ZhantaoLi/STM32_CAR/README.md

# STM32_CAR
 STM32小车资料整理

B站视频教程链接：

[STM32智能小车V1.5](https://www.bilibili.com/video/av253997024/)

[STM32智能小车V3.3](https://www.bilibili.com/video/av990827294)
