ZhantaoLi/STM32_CAR/平衡车网上例程/balance_car_4/README.md

# balance car

#### 介绍
这是一个通过STM32F103C8T6的hal库基于PID控制算法的平衡小车系统的硬件和软件设计

This is the hardware and software design of a balance car system based on PID control algorithm through STM32F103C8T6.
