ZhantaoLi/STM32_CAR/平衡车网上例程/平衡小车2/readme.txt

https://oshwhub.com/999jump999/stm32-ping-heng-xiao-ju
