ZhantaoLi/STM32_CAR/MPU6050卡尔曼滤波/程序源码/STM32F103C8T6驱动MPU6050程序(卡尔曼滤波_硬件IIC_OLED显示_串口上传)/README.TXT

实验器材:
	STM32F103C8T6系统板+MPU6050模块+0.96寸OLED显示屏+USB转TTL电平工具
	
实验目的:
	MPU6050陀螺仪数据解算（卡尔曼滤波）
	
硬件资源:
	MPU6050： SCL接PB10 SDA接PB11
	OLED： SCL接PA6 SDA接PA7
	指示灯：LED0--PC13
	串口1：RX--PA9  TX--PA10
实验现象:
	通过串口将陀螺仪数据上报，OLED实时显示数据。
注意事项:
	注意接线，硬件平台选择和适配。

该工程借鉴了很多平台的程序设计，本人能力有限，设计难免有问题和漏洞，欢迎大家和我交流。
	
			西安电子科技大学 
			刘亮设计
			QQ:1920108735
			2021年5月17日
