ZhantaoLi/STM32_CAR/MPU6050卡尔曼滤波/原理图/接线图.png

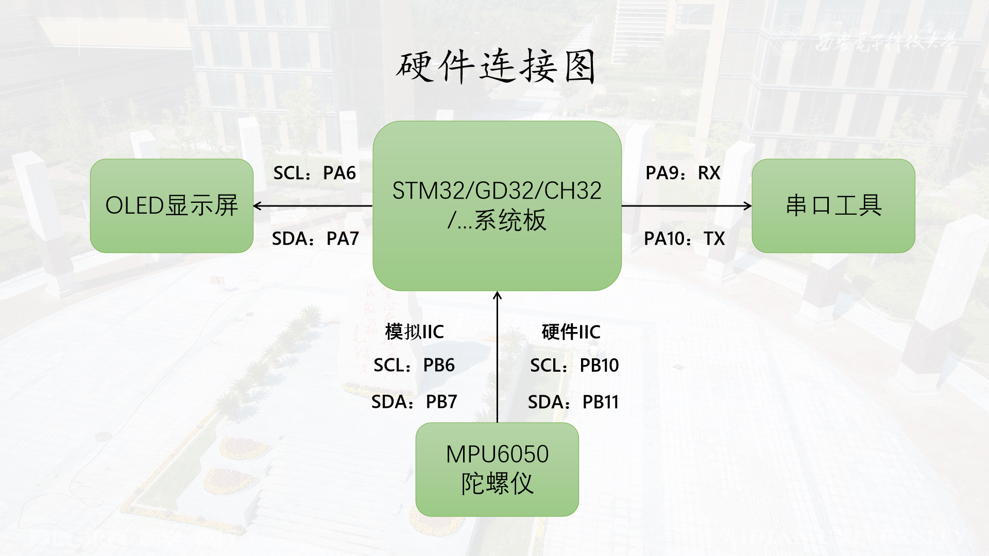
MPU6050卡尔曼滤波/原理图/接线图.png
