ZhantaoLi/STM32_CAR/STM32小车资料V1.5/04小车PCB硬件资料(你要的PCB电路板资料)/小车PCB资料PCB资料_V1.4/PCB图.png

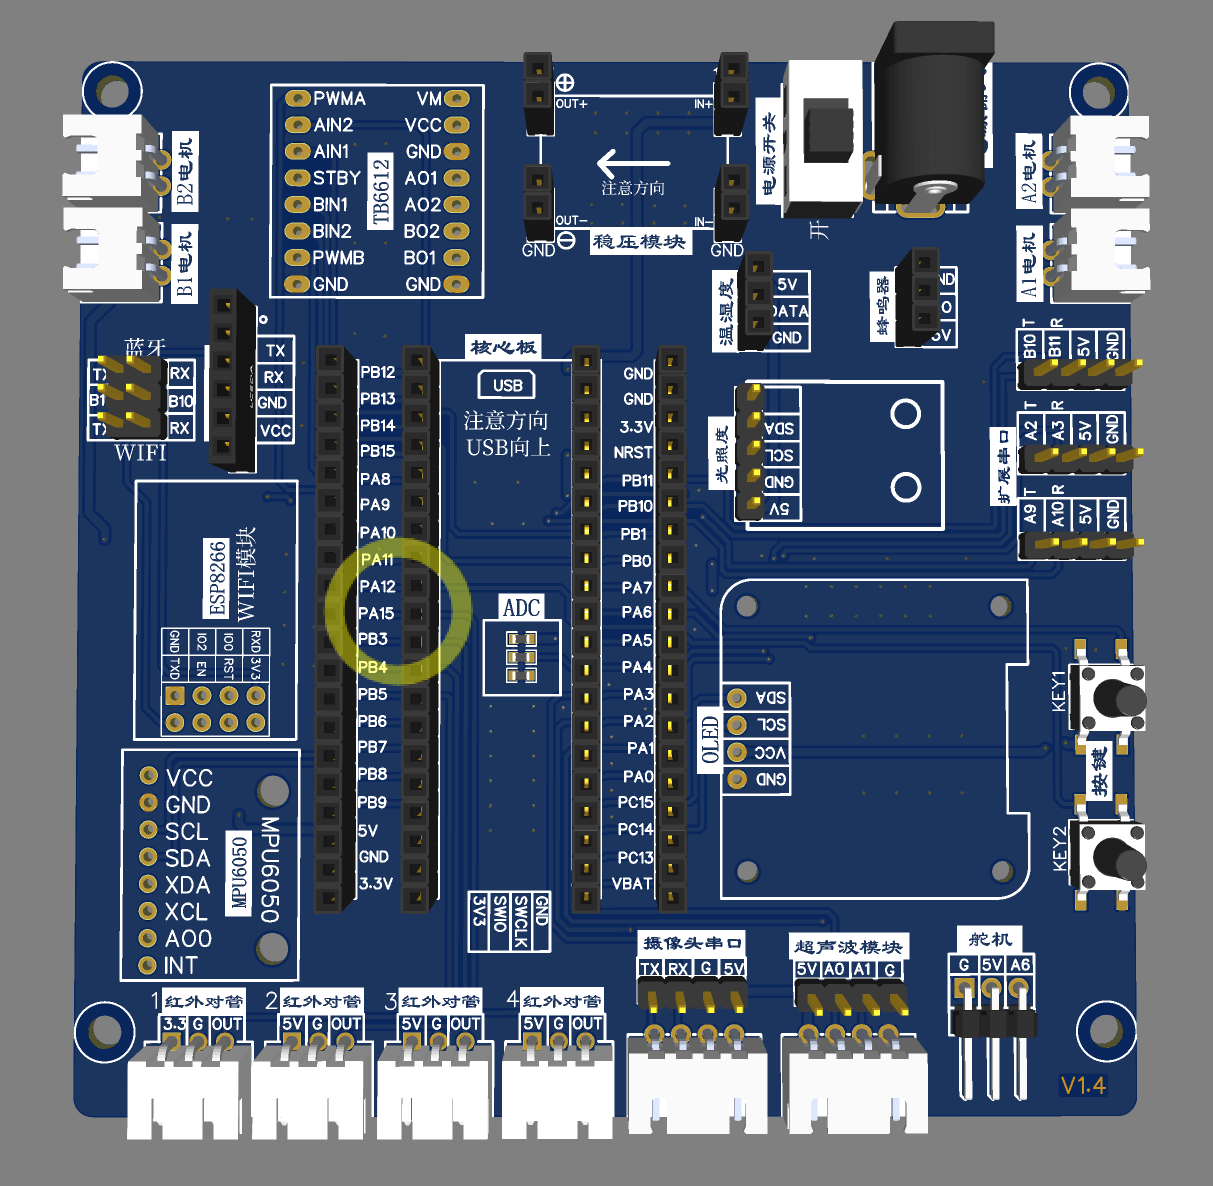
STM32小车资料V1.5/04小车PCB硬件资料(你要的PCB电路板资料)/小车PCB资料PCB资料_V1.4/PCB图.png
