ZhantaoLi/STM32_CAR/平衡车网上例程/平衡小车7/2.所需模块清单/模块清单.xlsx

 | 平衡小车所需元器件
序号 | 名称 | 数量 | 购买链接
1 | 3A可调降压模块 | 1 | 淘宝-优信电子 (https://item.taobao.com/item.htm?spm=a1z09.2.0.0.36012e8dqaJku5&id=522572489248&_u=d2b0l5used81)
2 | 拨动开关 | 1 | 淘宝-优信电子 (https://item.taobao.com/item.htm?spm=a1z09.2.0.0.36012e8dqaJku5&id=568771505825&_u=d2b0l5use6aa)
3 | 排母若干4P,6P,8P,11P,20P | 10 | 淘宝-优信电子 (https://item.taobao.com/item.htm?spm=a1z09.2.0.0.36012e8dqaJku5&id=522579376259&_u=d2b0l5us9700)
4 | 瓷片电容100nf | 2 | 淘宝-优信电子 (https://item.taobao.com/item.htm?spm=a1z10.3-c-s.w4002-21223910208.32.65656a4b7JaGSG&id=522575257637)
5 | 弯脚插座 | 2 | 淘宝 (https://detail.tmall.com/item.htm?id=565640066558&spm=a1z09.2.0.0.36012e8dqaJku5&_u=d2b0l5usc9b9)
6 | 直流减速电机带编码器 | 2 | 淘宝-轮趣科技 (https://item.taobao.com/item.htm?spm=a1z09.2.0.0.36012e8dqaJku5&id=45347924687&_u=d2b0l5us9096)
7 | OLED | 1 | 淘宝-优信电子 (https://item.taobao.com/item.htm?spm=a1z10.3-c-s.w4002-21223910208.21.309d6a4beyqYtj&id=571499835788)
8 | TB6612 | 1 | 淘宝 (https://item.taobao.com/item.htm?spm=a1z09.2.0.0.36012e8dqaJku5&id=616029257488&_u=d2b0l5usa89c)
9 | MPU6050 | 1 | 淘宝-优信电子 (https://item.taobao.com/item.htm?spm=a1z10.3-c-s.w4002-21223910208.13.70286a4bGJwrQH&id=522575310310)
10 | 按键 | 1 | 淘宝-优信电子 (https://item.taobao.com/item.htm?spm=a1z10.3-c-s.w4002-21223910208.26.fb176a4bUPIg1f&id=556973844714)
11 | 锂电池 | 1 | 淘宝 (https://item.taobao.com/item.htm?spm=a1z09.2.0.0.36012e8dqaJku5&id=558538974777&_u=d2b0l5us4ab7)
12 | HC-06无线蓝牙 | 1 | 淘宝-优信电子 (https://item.taobao.com/item.htm?spm=a1z10.3-c-s.w4002-21223910208.56.69f76a4bhLQfU9&id=669500565144)
