ZhantaoLi/STM32_CAR/STM32小车相关资料V3.3/03小车硬件资料(包括PCB-元件清单-模块资料等)/C模块资料/3-DAPLINK+4P杜邦线~STM烧录器/DAPLINK+4P杜邦线~STM烧录器/DAPLINK客户资料/相关问题（出错时可以看一下）.docx

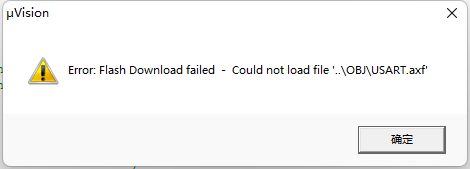
[picture p67: figure]

出现这个提示框可能是程序没有编译，程序要先编译通过再下载
