ZhantaoLi/STM32_CAR/(list of files, cad)

Other CAD files:
平衡车网上例程/balance_car_4/1.Hardware/三视图.dwg
