ZhantaoLi/STM32_CAR/平衡车网上例程/平衡小车3/1.AD原理图/平衡小车硬件原理图.pdf

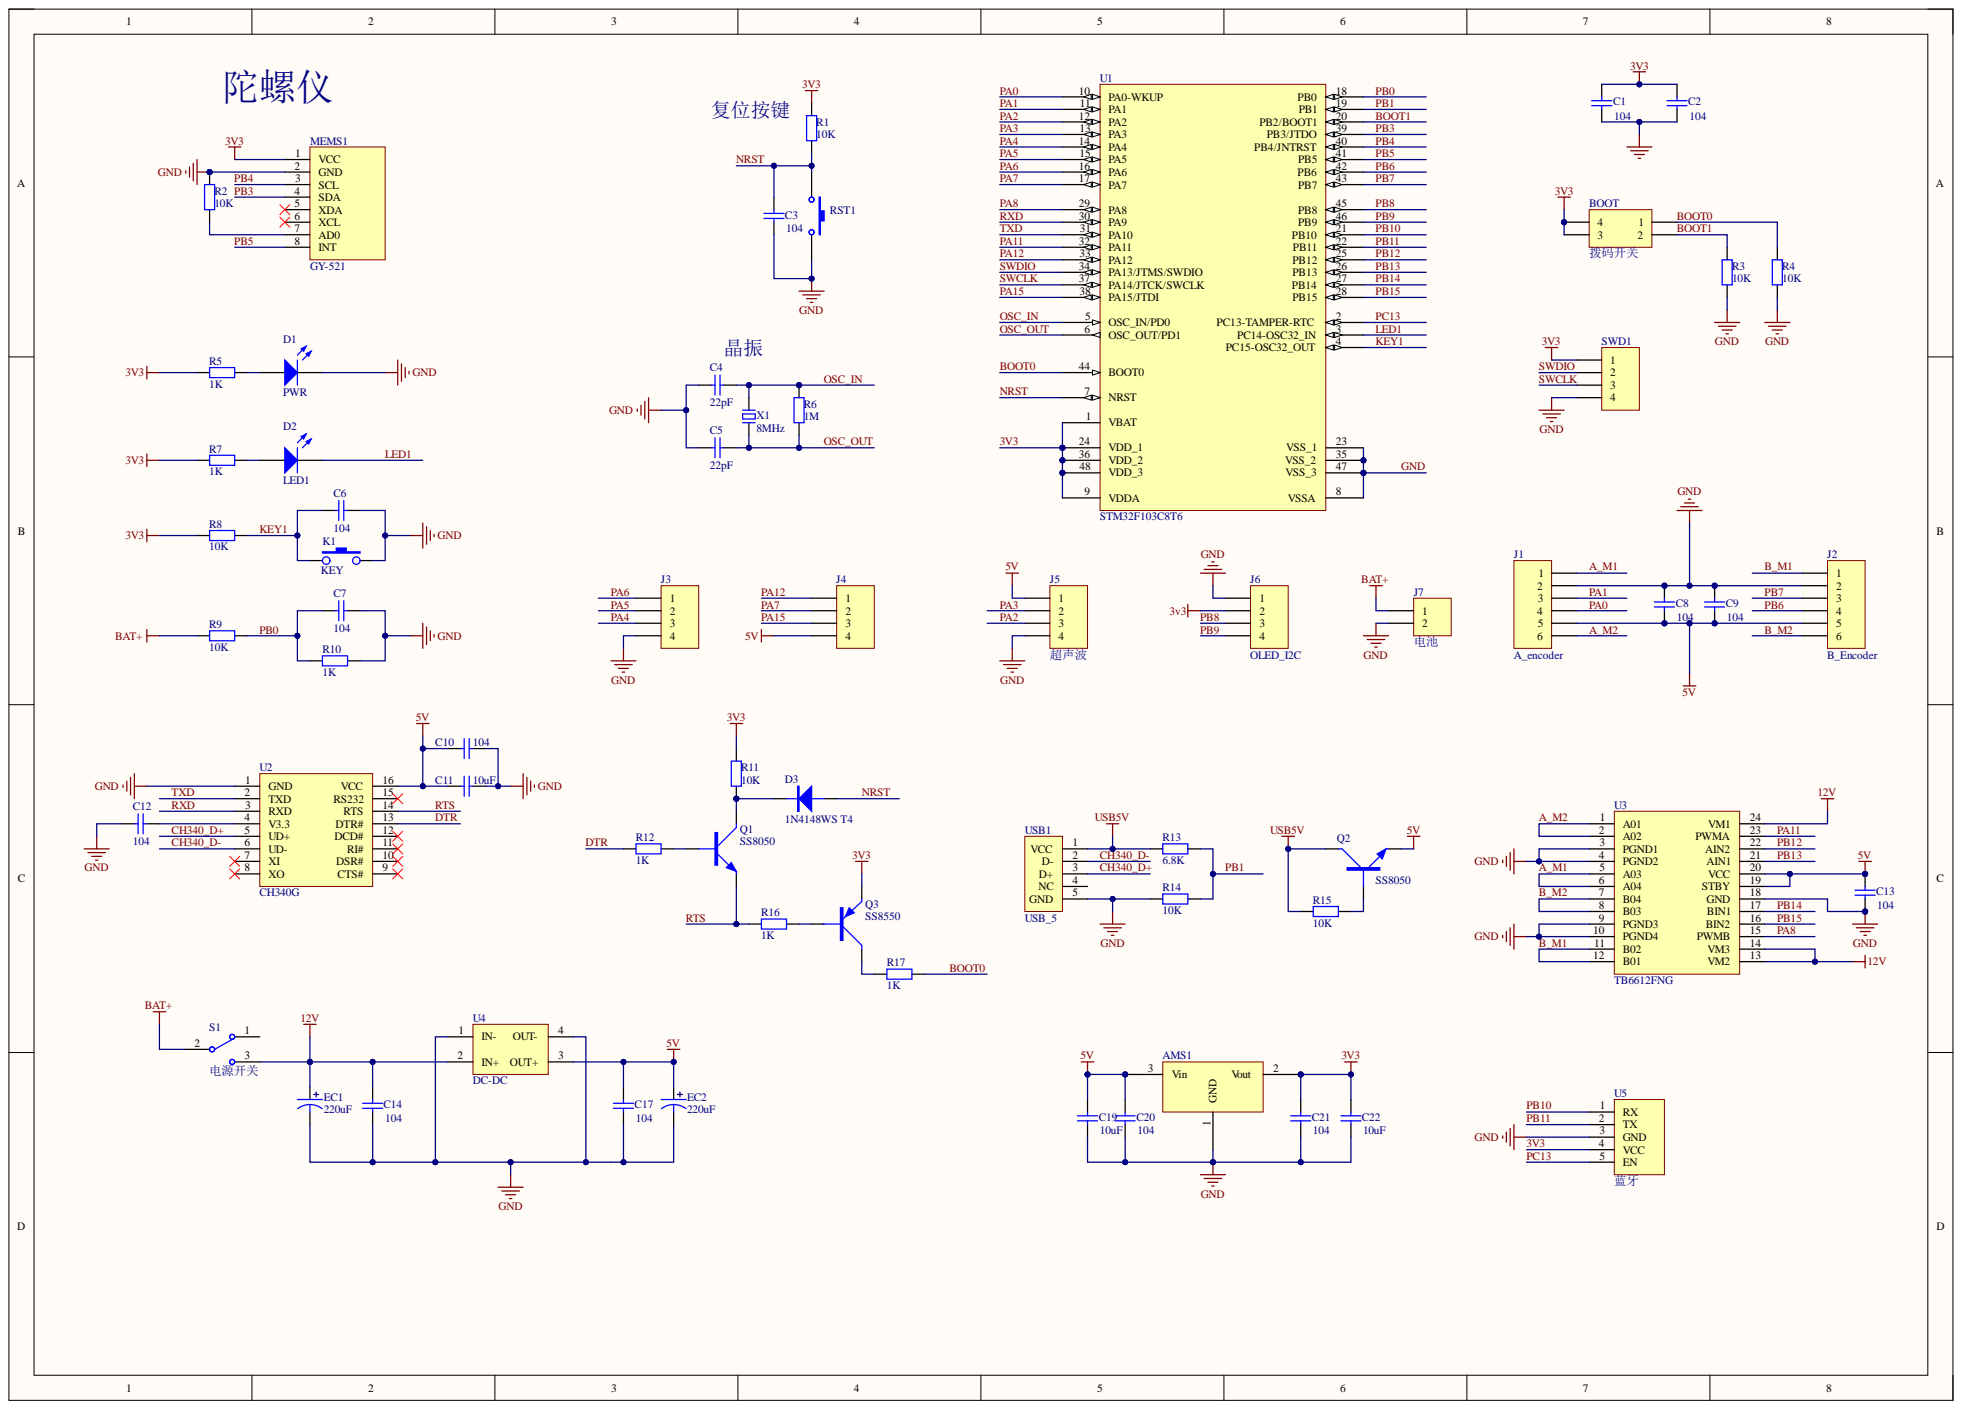
[picture p71: page 1]

B03 8 | | PB14
PGND3 9 | PB15
PGND4 10
B02 11

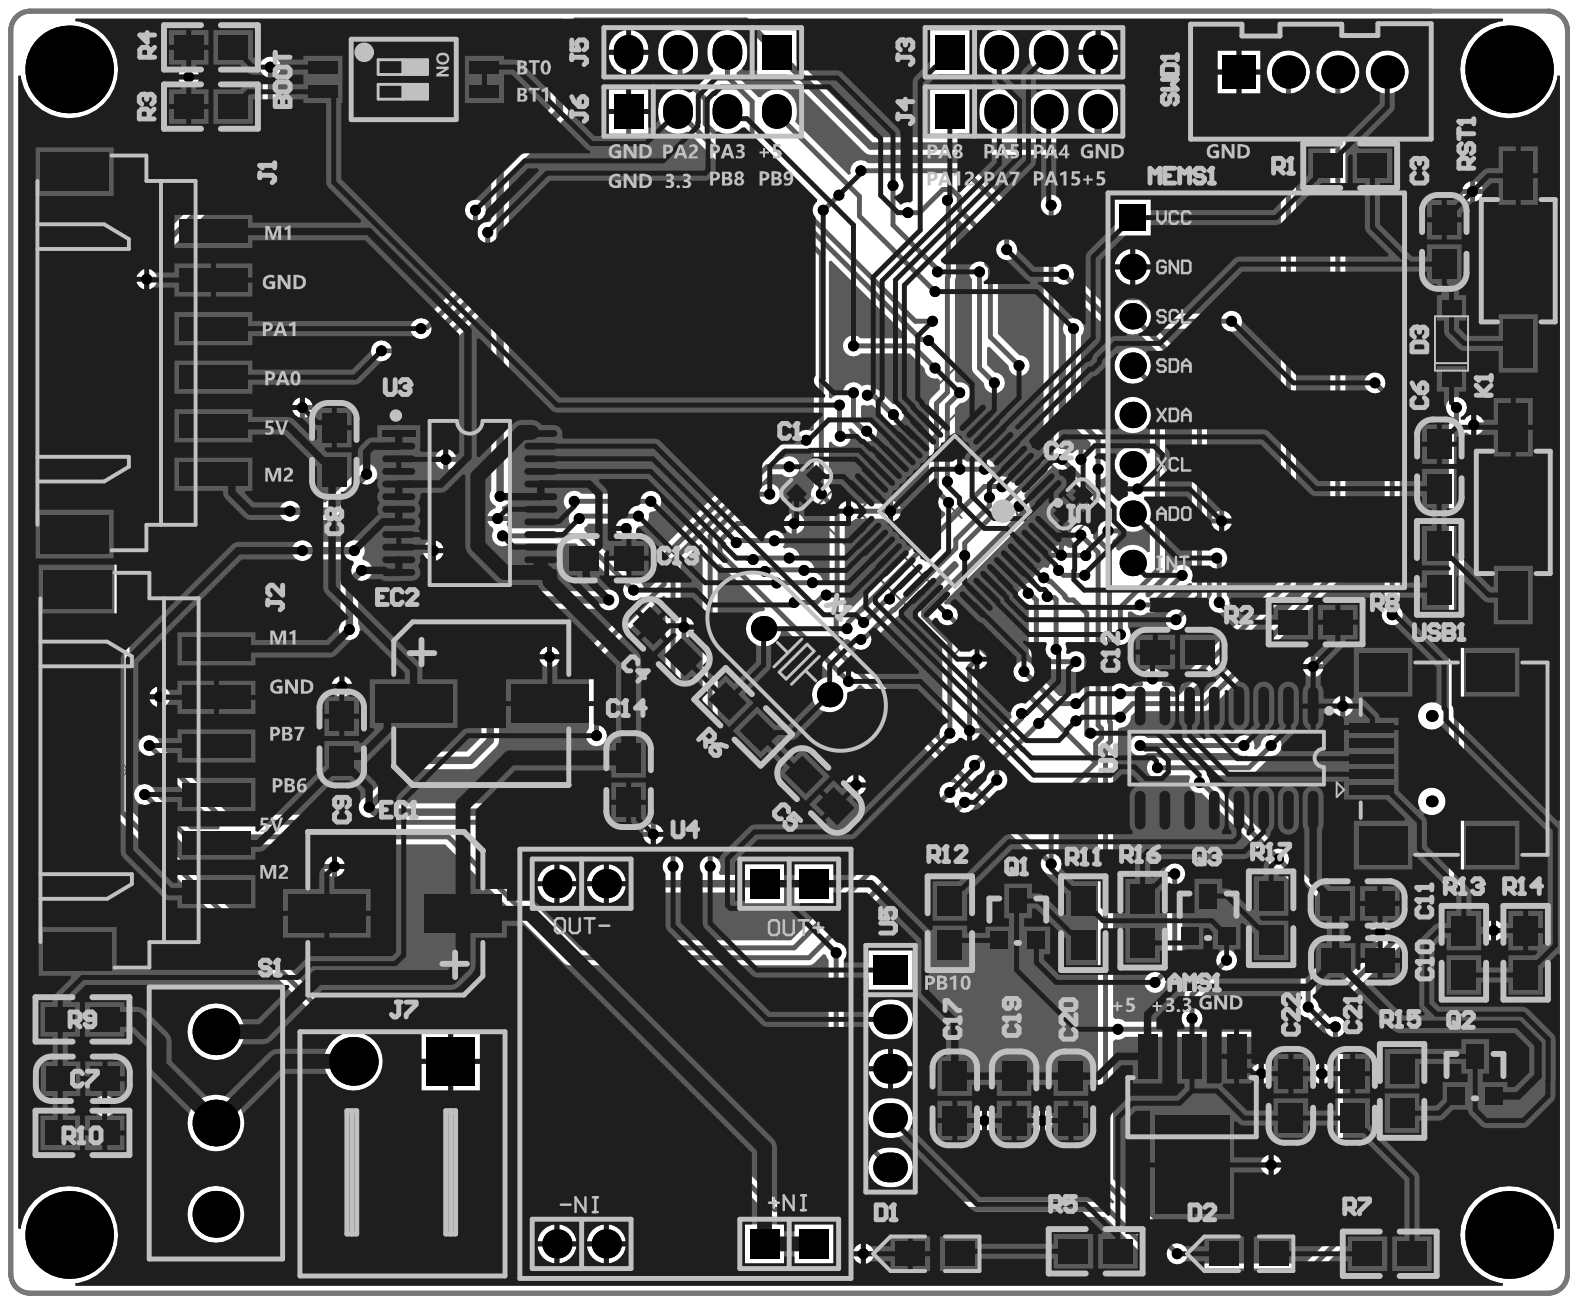
[picture p72: page 2]

Comment | Description | Designator | Footprint | LibRef | Quantity
AMS1117 | 三端稳压芯片 | AMS1 | SOT223 | AMS1117 | 1
拨码开关 | | BOOT | SMD-2P | BOOT | 1
Cap | Capacitor | C1, C2 | 0603C | Cap | 2
Cap | Capacitor | C3, C4, C5, C6, C7, C8, C9, C10, C11, C12, C13, C14, C17, C19, C20, C21, C22 | 0805C | Cap | 17
PWR | Typical INFRARED GaAs LED | D1 | LED-0805Y | LED0 | 1
LED1 | Typical INFRARED GaAs LED | D2 | LED-0805Y | LED0 | 1
1N4148WS T4 | 普通二极管 | D3 | SOD-123 | DIODE | 1
220uF | 贴片电解电容 | EC1, EC2 | SMD-EC8X8X10 | SMD_ECAP | 2
A_encoder | | J1 | XH2.54-WS-6P | A_encoder | 1
B_Encoder | | J2 | XH2.54-WS-6P | B_Encoder | 1
J? | | J3, J4 | 4脚排针 | 4xIO | 2
超声波 | | J5 | 四脚排母 | 超声波 | 1
OLED_I2C | | J6 | 四脚排母 | OLED_I2C | 1
电池 | | J7 | 插拔式端子 | OLED_I2C_1 | 1
KEY | | K1 | SMD-3X6X5 | KEY | 1
GY-521 | MEMS, MPU6050 Compontents | MEMS1 | 陀螺仪 | GY-521 | 1
SS8050 | NPN三极管 | Q1, Q2 | SOT-23 | NPN | 2
SS8550 | PNP三极管 | Q3 | SOT-23 | PNP | 1
Res2 | Resistor | R1, R2, R3, R4, R5, R6, R7, R8, R9, R10, R11, R12, R13, R14, R15, R16, R17 | 0805R | Res2 | 17
SW-PB | Switch | RST1 | SMD-3X6X5 | SW-PB | 1
电源开关 | | S1 | SS-12D10 | SS-12F23 | 1
XH-4A | Header, 4-Pin | SWD1 | XH2.54-LI-4P | Header 4 | 1
STM32F103C8T6 | | U1 | STM32F103C8T6 | STM32F103C8T6 | 1
CH340G | | U2 | SOP16 | CH340 | 1
TB6612FNG | | U3 | SSOP24 | TB6612FNG | 1
DC-DC | Power Module | U4 | DC_DC DOWN | DC-DC | 1
蓝牙 | | U5 | Fe-HDR1X5/2.54-S | 蓝牙 | 1
USB_5 | | USB1 | USB-MINI-A | USB_5 | 1
8MHz | 2脚无源脚晶振 | X1 | OSC HC-49S | XTAL-2P | 1
