ZhantaoLi/STM32_CAR/STM32小车资料V1.5/04小车PCB硬件资料(你要的PCB电路板资料)/小车PCB资料PCB资料_V1.4/小车原理图V1.4(这个1.4的esp-01s是错的如果你不使用WiFi可以忽略).pdf

5V

## GND

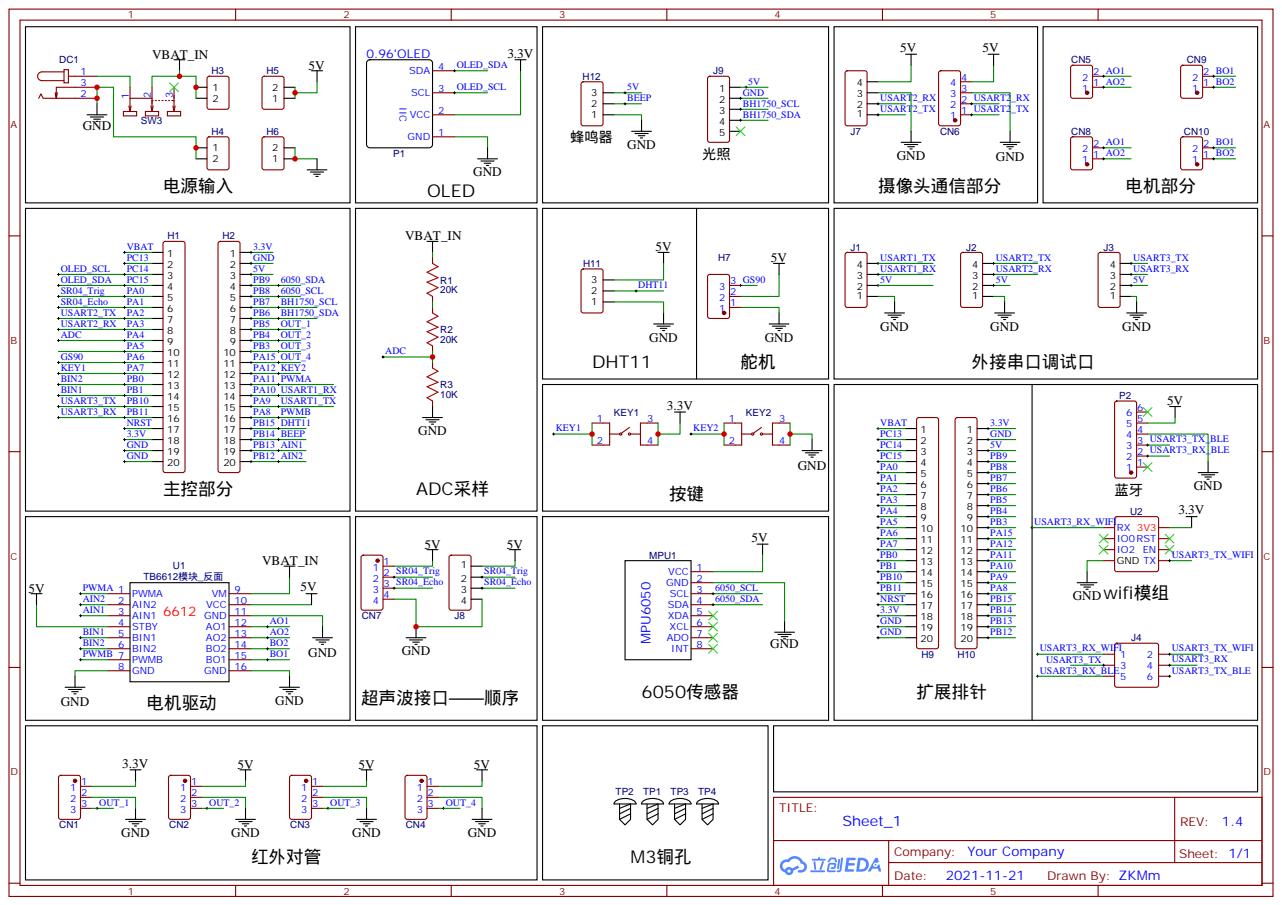
[picture p73: page 1]
