ZhantaoLi/STM32_CAR/STM32小车相关资料V3.3/03小车硬件资料(包括PCB-元件清单-模块资料等)/A原理图与PCB工程/原理图-PDF-STM32小车车V3.3.0_2022-12-27.pdf

5V

## GND

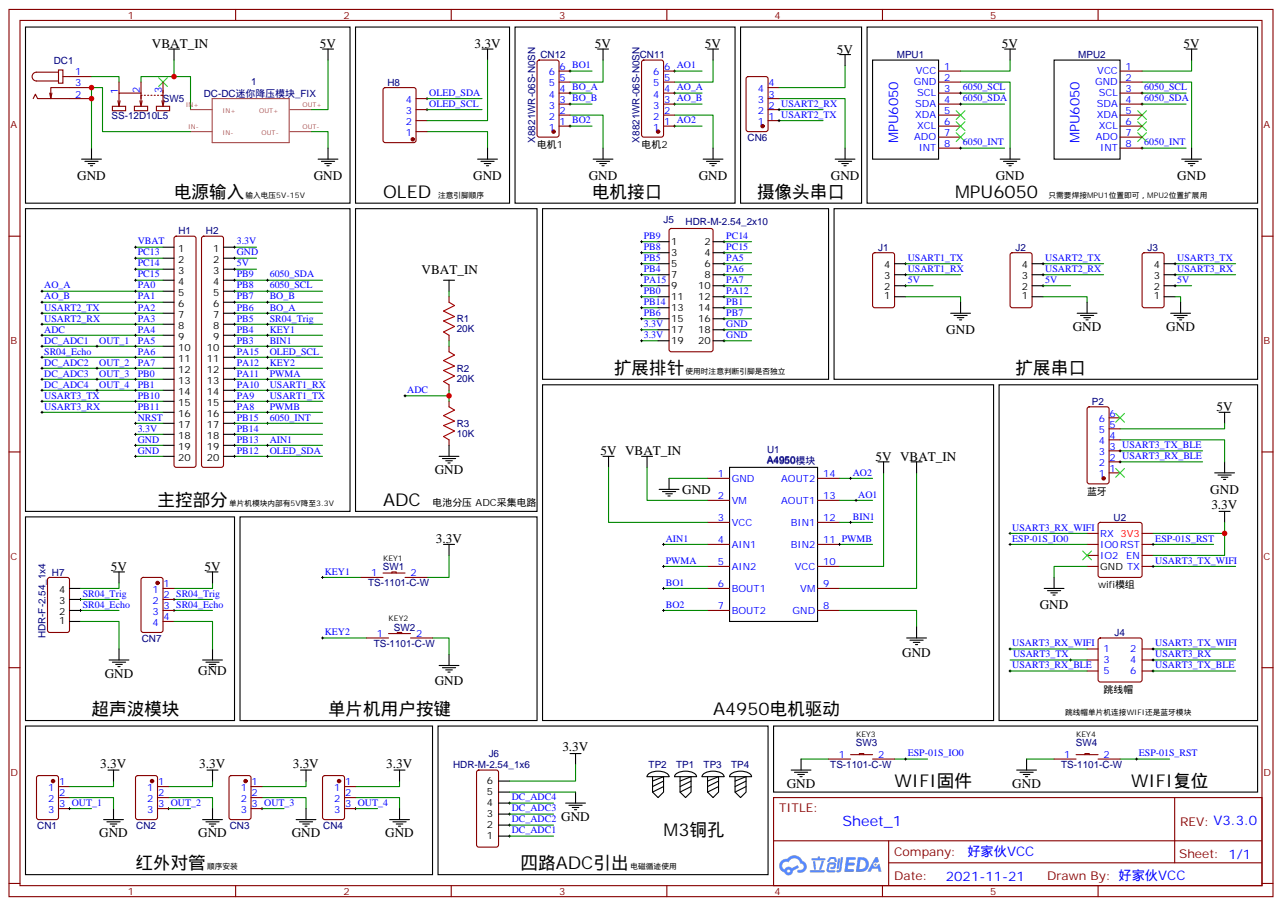
[picture p74: page 1]
