ZhantaoLi/STM32_CAR/(list of files, drawings)

Other design files:
STM32小车相关资料V3.3/03小车硬件资料(包括PCB-元件清单-模块资料等)/A原理图与PCB工程/原理图和PCB工程-内有使用说明-STM32小车车V3.3.0/PCB_STM32小车V3.3.0_2023-02-14.json
STM32小车相关资料V3.3/03小车硬件资料(包括PCB-元件清单-模块资料等)/A原理图与PCB工程/原理图和PCB工程-内有使用说明-STM32小车车V3.3.0/SCH_STM32小车车V3.3.0_2023-02-14.json
STM32小车相关资料V3.3/03小车硬件资料(包括PCB-元件清单-模块资料等)/C模块资料/1-STM32F103C8T6最小系统版/60918-STM32（C8T6）/STM32F103C8T6.SCHLIB
STM32小车相关资料V3.3/03小车硬件资料(包括PCB-元件清单-模块资料等)/C模块资料/1-STM32F103C8T6最小系统版/60918-STM32（C8T6）/STM32F103C8T6核心板.PcbDoc
STM32小车相关资料V3.3/03小车硬件资料(包括PCB-元件清单-模块资料等)/C模块资料/1-STM32F103C8T6最小系统版/60918-STM32（C8T6）/STM32F103C8T6核心板.PcbLib
STM32小车相关资料V3.3/03小车硬件资料(包括PCB-元件清单-模块资料等)/C模块资料/1-STM32F103C8T6最小系统版/60918-STM32（C8T6）/STM32F103C8T6核心板尺寸.PcbDoc
平衡车网上例程/balance_car_4/1.Hardware/平衡小车PCB/Board1/PCB1.pcbdoc
平衡车网上例程/balance_car_4/1.Hardware/平衡小车PCB/Board1/Schematic1/1_P1.schdoc
平衡车网上例程/平衡小车3/1.AD原理图/ZHZ_Balance.PrjPcb
平衡车网上例程/平衡小车3/1.AD原理图/ZHZ_Balance.SchDoc
平衡车网上例程/平衡小车3/1.AD原理图/ZHZ_Balance.SCHLIB
平衡车网上例程/平衡小车5/PCB1.PcbDoc
平衡车网上例程/平衡小车5/PCB_Project1.PrjPCB
平衡车网上例程/平衡小车5/Sheet1.SchDoc
平衡车网上例程/平衡小车7/1.涉及PCB/主控/STM32F103C8T6/projct_PCB.PcbDoc
平衡车网上例程/平衡小车7/1.涉及PCB/主控/STM32F103C8T6/project_Sheet.SchDoc
平衡车网上例程/平衡小车7/1.涉及PCB/主控/STM32F103C8T6/STM32F103C8T6.PrjPcb
平衡车网上例程/平衡小车7/1.涉及PCB/底盘/PCB_PCB_平衡小车底盘_2022-06-13.json
平衡车网上例程/平衡小车7/1.涉及PCB/电池电压检测模块/PCB_PCB_电池电压检测模块_2_2022-06-13.json
平衡车网上例程/平衡小车7/1.涉及PCB/电池电压检测模块/SCH_电池电压检测模块_2022-06-13.json
平衡车网上例程/平衡小车7/1.涉及PCB/电源扩展板/1.0/PCB_PCB_平衡小车电源扩展板_2022-06-13.json
平衡车网上例程/平衡小车7/1.涉及PCB/电源扩展板/2.0-增加超声波/PCB_PCB_平衡小车电源扩展板-升级版_2022-06-13.json
