ZhantaoLi/STM32_CAR/平衡车网上例程/balance_car_2/Core/Src/main.c

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
/* Includes ------------------------------------------------------------------*/
#include "main.h"
#include "tim.h"
#include "usart.h"
#include "gpio.h"

/* USER CODE BEGIN Includes */
#include "stdio.h"
#include "oled.h"
#include "motor.h"
#include "niming.h"
#include "pid.h"
#include "cJSON.h"
#include "string.h"
/* USER CODE END Includes */


/* USER CODE BEGIN PV */
extern float Motor1Speed;
extern float Motor2Speed;
int Motor1Pwm;
int Motor2Pwm;

extern tPid pidMotor1Speed;
extern uint8_t Usart1_ReadBuf[255]; // 串口1 缓冲数组
float p, i, d, a;
/* USER CODE END PV */

void SystemClock_Config(void);
/* USER CODE BEGIN PFP */
uint8_t Usart_WaitReasFinish(void);
/* USER CODE END PFP */

/**
  * @brief  The application entry point.
  * @retval int
  */
int main(void)
{
  /* MCU Configuration--------------------------------------------------------*/

  /* Reset of all peripherals, Initializes the Flash interface and the Systick. */
  HAL_Init();

  /* Configure the system clock */
  SystemClock_Config();

  /* Initialize all configured peripherals */
  MX_GPIO_Init();
  MX_TIM1_Init();
  MX_TIM4_Init();
  MX_USART1_UART_Init();
  MX_USART2_UART_Init();
  MX_TIM3_Init();
  /* USER CODE BEGIN 2 */
    OLED_Init(); // 初始化OLED
    OLED_Clear();
    HAL_TIM_PWM_Start(&htim1, TIM_CHANNEL_1);       // 开启定时器1 通道1 PWM输出
    HAL_TIM_PWM_Start(&htim1, TIM_CHANNEL_4);       // 开启定时器1 通道4 PWM输出
    HAL_TIM_Encoder_Start(&htim3, TIM_CHANNEL_ALL); // 开启定时器3
    HAL_TIM_Encoder_Start(&htim4, TIM_CHANNEL_ALL); // 开启定时器4
    HAL_TIM_Base_Start_IT(&htim3);                  // 开启定时器3 中断
    HAL_TIM_Base_Start_IT(&htim4);                  // 开启定时器4 中断

    HAL_TIM_Base_Start_IT(&htim1);               // 开启定时器1 中断
    __HAL_UART_ENABLE_IT(&huart1, UART_IT_RXNE); // 开启串口1接收中断
    PID_init();
    cJSON *cJsonData, *cJsonVlaue;
  /* USER CODE END 2 */

  /* Infinite loop */
  /* USER CODE BEGIN WHILE */
    while (1)
    {
        OLED_ShowCHinese(0, 0, 0);   // 中
        OLED_ShowCHinese(18, 0, 1);  // 景
        OLED_ShowCHinese(36, 0, 2);  // 园
        OLED_ShowCHinese(54, 0, 3);  // 电
        OLED_ShowCHinese(72, 0, 4);  // 子
        OLED_ShowCHinese(90, 0, 5);  // 科
        OLED_ShowCHinese(108, 0, 6); // 技
        //	uint8_t c_Data[] = "test\r\n";
        //	HAL_UART_Transmit(&huart1,c_Data,sizeof(c_Data),0xFFFF);
        //	HAL_Delay(1000);
        printf("Motor1Speed:%.2f\r\n", Motor1Speed);
        printf("Motor2Speed:%.2f\r\n", Motor2Speed);
    /* USER CODE END WHILE */

    /* USER CODE BEGIN 3 */
        Motor_Set(PID_realize(&pidMotor1Speed, Motor1Speed), Motor2Pwm);

        //	printf("Motor1Speed:%.2f Motor1Pwm:%d\r\n",Motor1Speed,Motor1Pwm);
        //	printf("Motor2Speed:%.2f Motor2Pwm:%d\r\n",Motor2Speed,Motor2Pwm);
        HAL_Delay(10);

        ANO_DT_Send_F2(Motor1Speed * 100, 3.0 * 100, Motor2Speed * 100, 3.0 * 100);

        if (Usart_WaitReasFinish() == 0) // 是否接收完毕
        {
            cJsonData = cJSON_Parse((const char *)Usart1_ReadBuf);
            if (cJSON_GetObjectItem(cJsonData, "p") != NULL)
            {
                cJsonVlaue = cJSON_GetObjectItem(cJsonData, "p");
                p = cJsonVlaue->valuedouble;
                pidMotor1Speed.Kp = p;
            }
            if (cJSON_GetObjectItem(cJsonData, "i") != NULL)
            {
                cJsonVlaue = cJSON_GetObjectItem(cJsonData, "i");
                i = cJsonVlaue->valuedouble;
                pidMotor1Speed.Ki = i;
            }
            if (cJSON_GetObjectItem(cJsonData, "d") != NULL)
            {
                cJsonVlaue = cJSON_GetObjectItem(cJsonData, "d");
                d = cJsonVlaue->valuedouble;
                pidMotor1Speed.Kd = d;
            }
            if (cJSON_GetObjectItem(cJsonData, "a") != NULL)
            {

                cJsonVlaue = cJSON_GetObjectItem(cJsonData, "a");
                a = cJsonVlaue->valuedouble;
                pidMotor1Speed.target_val = a;
            }
            if (cJsonData != NULL)
            {
                cJSON_Delete(cJsonData); // 释放空间、但是不能删除cJsonVlaue不然会 出现异常错误
            }
            memset(Usart1_ReadBuf, 0, 255); // 清空接收buf，注意这里不能使用strlen
        }
        printf("P:%.3f  I:%.3f  D:%.3f A:%.3f\r\n", p, i, d, a);
    }
  /* USER CODE END 3 */
}

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
