ZhantaoLi/STM32_CAR/平衡车网上例程/平衡小车5/FreeRTOS_F103_7.0/HARDWARE/src/control.c

#include "control.h"	


float	balance_UP_KP=280; 	 //直立环PD
float	balance_UP_KD=0.8;

float	velocity_KP=90;		//速度环PI
float	velocity_KI=0.45;

u8		UltrasonicWave_Voltage_Counter=0;

int		Flag_Qian,Flag_Hou,Flag_Left,Flag_Right;	//蓝牙遥控相关的变量
int		Encoder_Left,Encoder_Right;					//左右编码器的脉冲计数
float	pitch,roll,yaw;								//欧拉角(姿态角)
short	aacx,aacy,aacz;								//加速度传感器原始数据
short	gyrox,gyroy,gyroz;							//陀螺仪原始数据
int		Encoder_Left,Encoder_Right;					//左右编码器的脉冲计数


int myabs(int a)
{ 		   
	  int temp;
		if(a<0)  temp=-a;  
	  else temp=a;
	  return temp;
}
/**************************************************************************
函数功能：直立PD控制
入口参数：角度、机械平衡角度（机械中值）、角速度
返回  值：直立控制PWM
**************************************************************************/
int balance_UP(float Angle,float Mechanical_balance,float Gyro)
{  
   float Bias;
	 int balance;
	 Bias=Angle-Mechanical_balance;    							 //===求出平衡的角度中值和机械相关
	 balance=balance_UP_KP*Bias+balance_UP_KD*Gyro;  //===计算平衡控制的电机PWM  PD控制   kp是P系数 kd是D系数 
	 return balance;
}

/**************************************************************************
函数功能：速度PI控制
入口参数：电机编码器的值
返回  值：速度控制PWM
**************************************************************************/
int velocity(int encoder_left,int encoder_right)
{  
    static float Velocity,Encoder_Least,Encoder,Movement;
	  static float Encoder_Integral;
		if(1==Flag_Qian)				
		{
			Movement=20;
		}
		else if(1==Flag_Hou)//接收到蓝牙APP遥控数据		
		{
			Movement=-20;//设定速度
		}
		else//没有接受到任何的数据
		{	
			Movement=0;
		}
   //=============速度PI控制器=======================//	
		Encoder_Least =(Encoder_Left+Encoder_Right)-0;                    //===获取最新速度偏差==测量速度（左右编码器之和）-目标速度（此处为零） 
		Encoder *= 0.8;		                                                //===一阶低通滤波器       
		Encoder += Encoder_Least*0.2;	                                    //===一阶低通滤波器    
		Encoder_Integral +=Encoder;                                       //===积分出位移 积分时间：10ms
		Encoder_Integral=Encoder_Integral-Movement;                       //===接收遥控器数据，控制前进后退
		if(Encoder_Integral>10000)  	Encoder_Integral=10000;             //===积分限幅
		if(Encoder_Integral<-10000)		Encoder_Integral=-10000;            //===积分限幅	
		Velocity=Encoder*velocity_KP+Encoder_Integral*velocity_KI;        //===速度控制	
	  if(pitch<-40||pitch>40) 			Encoder_Integral=0;     						//===电机关闭后清除积分
	  return Velocity;
}
/**************************************************************************
函数功能：转向PD控制
入口参数：电机编码器的值、Z轴角速度
返回  值：转向控制PWM
**************************************************************************/
int turn(int encoder_left,int encoder_right,float gyro)//转向控制
{
	 static float Turn_Target,Turn,Encoder_temp,Turn_Convert=0.9,Turn_Count;
	  float Turn_Amplitude=44,Kp=20,Kd=0;     
	  //=============遥控左右旋转部分=======================//
	  //这一部分主要是根据旋转前的速度调整速度的起始速度，增加小车的适应性
  	if(1==Flag_Left||1==Flag_Right)                      
		{
			if(++Turn_Count==1)
			Encoder_temp=myabs(encoder_left+encoder_right);      
			Turn_Convert=55/Encoder_temp;
			if(Turn_Convert<0.6)Turn_Convert=0.6;
			if(Turn_Convert>3)Turn_Convert=3;
		}	
	  else
		{
			Turn_Convert=0.9;
			Turn_Count=0;
			Encoder_temp=0;
		}			
		if(1==Flag_Left)	           Turn_Target-=Turn_Convert;
		else if(1==Flag_Right)	     Turn_Target+=Turn_Convert; 
		else Turn_Target=0;
    if(Turn_Target>Turn_Amplitude)  Turn_Target=Turn_Amplitude;    //===转向	速度限幅
	  if(Turn_Target<-Turn_Amplitude) Turn_Target=-Turn_Amplitude;
		if(Flag_Qian==1||Flag_Hou==1)  Kd=0.5;        
		else Kd=0;   //转向的时候取消陀螺仪的纠正 有点模糊PID的思想
  	//=============转向PD控制器=======================//
		Turn=-Turn_Target*Kp-gyro*Kd;                 //===结合Z轴陀螺仪进行PD控制
	  return Turn;
}
