ZhantaoLi/STM32_CAR/平衡车网上例程/balance_car_2/HARDWARE/MOTOR/motor.h

#ifndef  MOTOR_H__
#define  MOTOR_H__

#include  "main.h"



#define  AIN1_SET    HAL_GPIO_WritePin(AIN1_GPIO_Port,AIN1_Pin,GPIO_PIN_SET)
#define  AIN1_RESET  HAL_GPIO_WritePin(AIN1_GPIO_Port,AIN1_Pin,GPIO_PIN_RESET)
#define  AIN2_SET    HAL_GPIO_WritePin(AIN2_GPIO_Port,AIN2_Pin,GPIO_PIN_SET)
#define  AIN2_RESET  HAL_GPIO_WritePin(AIN2_GPIO_Port,AIN2_Pin,GPIO_PIN_RESET)

#define  BIN1_SET    HAL_GPIO_WritePin(BIN1_GPIO_Port,BIN1_Pin,GPIO_PIN_SET)
#define  BIN1_RESET  HAL_GPIO_WritePin(BIN1_GPIO_Port,BIN1_Pin,GPIO_PIN_RESET)
#define  BIN2_SET    HAL_GPIO_WritePin(BIN2_GPIO_Port,BIN2_Pin,GPIO_PIN_SET)
#define  BIN2_RESET  HAL_GPIO_WritePin(BIN2_GPIO_Port,BIN2_Pin,GPIO_PIN_RESET)



void Motor_Set(int Motor1,int Motor2);
#endif
