ZhantaoLi/STM32_CAR/平衡车网上例程/平衡小车5/FreeRTOS_F103_7.0/HARDWARE/Hardware.h

#ifndef __HARDWARE_H
#define __HARDWARE_H	

#include "delay.h"
#include "led.h"
#include "adc.h"
#include "usart.h"
#include "timer.h"
#include "stmflash.h"
#include "I2C.h"
#include "exti.h"



#include "mpu6050.h"
#include "inv_mpu.h"
#include "inv_mpu_dmp_motion_driver.h"










void _HARDWARE_INT(void);
	
#endif
