ZhantaoLi/STM32_CAR/平衡车网上例程/平衡小车2/Hardware/Encoder.c

#include "stm32f10x.h"                  // Device header

void Encoder_TIM3_Init(void)   //定时器3编码器初始化
{
	RCC_APB1PeriphClockCmd(RCC_APB1Periph_TIM3,ENABLE);
	RCC_APB2PeriphClockCmd(RCC_APB2Periph_GPIOA,ENABLE);
	
	GPIO_InitTypeDef GPIO_InitStructure;
	GPIO_InitStructure.GPIO_Mode = GPIO_Mode_IN_FLOATING;
	GPIO_InitStructure.GPIO_Pin = GPIO_Pin_6 | GPIO_Pin_7;
	GPIO_InitStructure.GPIO_Speed = GPIO_Speed_50MHz;
	GPIO_Init(GPIOA,&GPIO_InitStructure);		
	
	TIM_TimeBaseInitTypeDef TIM_TimeBaseInitStructure;
	TIM_TimeBaseInitStructure.TIM_ClockDivision = TIM_CKD_DIV1;
	TIM_TimeBaseInitStructure.TIM_CounterMode = TIM_CounterMode_Up;  //向上计数
	TIM_TimeBaseInitStructure.TIM_Period = 65535;    //ARR(0~65535)      1s
	TIM_TimeBaseInitStructure.TIM_Prescaler = 0;  //PSC(0~65535)      定时频率=72M/(PSC+1)/(ARR+1)
	TIM_TimeBaseInitStructure.TIM_RepetitionCounter = 0;   //重复计数器（高级计数器特有）	
	TIM_TimeBaseInit(TIM3,&TIM_TimeBaseInitStructure);
	
	TIM_EncoderInterfaceConfig(TIM3,TIM_EncoderMode_TI12,TIM_ICPolarity_Rising,TIM_ICPolarity_Rising);//配置编码器模式
	
	TIM_ICInitTypeDef TIM_ICInitStructure;
	TIM_ICStructInit(&TIM_ICInitStructure);//初始化输入捕获
	TIM_ICInitStructure.TIM_ICFilter=10;
	TIM_ICInit(TIM3,&TIM_ICInitStructure);
	
	TIM_ITConfig(TIM3,TIM_IT_Update,ENABLE);//配置溢出更新中断标志位
	TIM_SetCounter(TIM3,0);//清零定时器计数值
	
	TIM_Cmd(TIM3,ENABLE);
}

void Encoder_TIM4_Init(void)    //定时器4编码器初始化
{
	RCC_APB1PeriphClockCmd(RCC_APB1Periph_TIM4,ENABLE);
	RCC_APB2PeriphClockCmd(RCC_APB2Periph_GPIOA,ENABLE);
	
	GPIO_InitTypeDef GPIO_InitStructure;
	GPIO_InitStructure.GPIO_Mode = GPIO_Mode_IN_FLOATING;
	GPIO_InitStructure.GPIO_Pin = GPIO_Pin_6 | GPIO_Pin_7;
	GPIO_InitStructure.GPIO_Speed = GPIO_Speed_50MHz;
	GPIO_Init(GPIOB,&GPIO_InitStructure);		
	
	TIM_TimeBaseInitTypeDef TIM_TimeBaseInitStructure;
	TIM_TimeBaseInitStructure.TIM_ClockDivision = TIM_CKD_DIV1;
	TIM_TimeBaseInitStructure.TIM_CounterMode = TIM_CounterMode_Up;  //向上计数
	TIM_TimeBaseInitStructure.TIM_Period = 65535;    //ARR(0~65535)      1s
	TIM_TimeBaseInitStructure.TIM_Prescaler = 0;  //PSC(0~65535)      定时频率=72M/(PSC+1)/(ARR+1)
	TIM_TimeBaseInitStructure.TIM_RepetitionCounter = 0;   //重复计数器（高级计数器特有）	
	TIM_TimeBaseInit(TIM4,&TIM_TimeBaseInitStructure);
	
	TIM_EncoderInterfaceConfig(TIM4,TIM_EncoderMode_TI12,TIM_ICPolarity_Rising,TIM_ICPolarity_Rising);//配置编码器模式
	
	TIM_ICInitTypeDef TIM_ICInitStructure;
	TIM_ICStructInit(&TIM_ICInitStructure);//初始化输入捕获
	TIM_ICInitStructure.TIM_ICFilter=10;
	TIM_ICInit(TIM4,&TIM_ICInitStructure);
	
	TIM_ITConfig(TIM4,TIM_IT_Update,ENABLE);//配置溢出更新中断标志位
	TIM_SetCounter(TIM4,0);//清零定时器计数值
	
	TIM_Cmd(TIM4,ENABLE);
}

/**********************
编码器
速度读取函数
入口参数：定时器
**********************/
int Read_Speed(int TIMx)
{
	int value_1;
	switch(TIMx)
	{
		/*             1.采集编码器的计数值并保存 2.将定时器的计数值清零。*/
		case 3:value_1=(short)TIM_GetCounter(TIM3);TIM_SetCounter(TIM3,0);break;
		case 4:value_1=(short)TIM_GetCounter(TIM4);TIM_SetCounter(TIM4,0);break;
		default:value_1=0;
	}
	return value_1;
}

void TIM3_IRQHandler(void)
{
	if(TIM_GetITStatus(TIM3,TIM_IT_Update) == SET)
	{
		
		TIM_ClearITPendingBit(TIM3,TIM_IT_Update);
	}
}

void TIM4_IRQHandler(void)
{
	if(TIM_GetITStatus(TIM3,TIM_IT_Update) == SET)
	{
		
		TIM_ClearITPendingBit(TIM3,TIM_IT_Update);
	}
}
