ZhantaoLi/STM32_CAR/平衡车网上例程/平衡小车5/FreeRTOS_F103_7.0/SYSTEM/usart/usart.h

#ifndef __USART_H
#define __USART_H
#include "sys.h"
#include "stdio.h"	 

#define USART_REC_LEN  			200			//定义最大接收字节数 200
#define EN_USART1_RX 			1			//使能（1）/禁止（0）串口1接收
#define EN_USART2_RX 			1			//使能（1）/禁止（0）串口2接收
#define EN_USART3_RX 			0			//使能（1）/禁止（0）串口3接收

extern u8  USART1_RX_BUF[USART_REC_LEN];	//接收缓冲,最大USART_REC_LEN个字节.末字节为换行符 
extern u8  USART2_RX_BUF[USART_REC_LEN];	//接收缓冲,最大USART_REC_LEN个字节.末字节为换行符 
extern u8  USART3_RX_BUF[USART_REC_LEN];	//接收缓冲,最大USART_REC_LEN个字节.末字节为换行符 
extern u16 USART1_RX_STA;					//接收状态标记	
extern u16 USART2_RX_STA;					//接收状态标记
extern u16 USART3_RX_STA;					//接收状态标记
//如果想串口中断接收，请不要注释以下宏定义
void uart1_init(u32 pclk2,u32 bound);
void uart2_init(u32 pclk2,u32 bound);
void uart3_init(u32 pclk2,u32 bound);

void uart2_printf(char* fmt,...);

#endif	   
