ZhantaoLi/STM32_CAR/平衡车网上例程/balance_car_4/2.Frimware/Balance_Car/Core/Inc/Data_to_Matlab.h

/*
 * Data_to_Matlab.c.h
 *
 *  Created on: 2023年1月12日
 *      Author: HP
 */

#ifndef INC_DATA_TO_MATLAB_H_
#define INC_DATA_TO_MATLAB_H_

void Dec_To_Hex(float Input);

#endif /* INC_DATA_TO_MATLAB_H_ */
