ZhantaoLi/STM32_CAR/平衡车网上例程/balance_car_4/2.Frimware/Balance_Car/Core/Inc/Get_digits.h

/*
 * Get_digits.h
 *
 *  Created on: 2022年12月1日
 *      Author: HP
 */

#ifndef INC_GET_DIGITS_H_
#define INC_GET_DIGITS_H_

int Get_digits(float Input, float Digits);	//将浮点数类型的数据取小数点后几位

#endif /* INC_GET_DIGITS_H_ */
