ZhantaoLi/STM32_CAR/平衡车网上例程/平衡小车2/Hardware/AD.c

#include "stm32f10x.h"                  // Device header

void AD_Init(void)
{
	RCC_APB2PeriphClockCmd(RCC_APB2Periph_ADC1,ENABLE);
	RCC_APB2PeriphClockCmd(RCC_APB2Periph_GPIOA,ENABLE);
	
	RCC_ADCCLKConfig(RCC_PCLK2_Div6);   //分频  72MHZ / 6 = 12MHz
	
	GPIO_InitTypeDef GPIO_InitStructure;
	GPIO_InitStructure.GPIO_Mode = GPIO_Mode_AIN;   //AIN模式是ADC专属模式
	GPIO_InitStructure.GPIO_Pin = GPIO_Pin_4;
	GPIO_InitStructure.GPIO_Speed = GPIO_Speed_50MHz;
	GPIO_Init(GPIOA,&GPIO_InitStructure);
	
	ADC_RegularChannelConfig(ADC1,ADC_Channel_4,1,ADC_SampleTime_55Cycles5);
	
	ADC_InitTypeDef ADC_InitStructure;
	ADC_InitStructure.ADC_ContinuousConvMode = DISABLE;
	ADC_InitStructure.ADC_DataAlign = ADC_DataAlign_Right;  //右对齐
	ADC_InitStructure.ADC_ExternalTrigConv = ADC_ExternalTrigConv_None;  //内部软件触发
	ADC_InitStructure.ADC_Mode = ADC_Mode_Independent;    //独立模式
	ADC_InitStructure.ADC_NbrOfChannel = 1;
	ADC_InitStructure.ADC_ScanConvMode = DISABLE;
	ADC_Init(ADC1,&ADC_InitStructure);
	
	ADC_Cmd(ADC1,ENABLE);
	
	ADC_ResetCalibration(ADC1);   //开始复位校准
	while(ADC_GetResetCalibrationStatus(ADC1) == SET);  //获取复位校准状态
	ADC_StartCalibration(ADC1);   //启动校准
	while(ADC_GetCalibrationStatus(ADC1) == SET);   //等待校准完成
}

uint16_t AD_GetValue(void)
{
	ADC_SoftwareStartConvCmd(ADC1,ENABLE);
	while(ADC_GetFlagStatus(ADC1,ADC_FLAG_EOC) == RESET);   //等待转换完成
	return ADC_GetConversionValue(ADC1);    //ADC获取转换值
}
