ZhantaoLi/STM32_CAR/平衡车网上例程/平衡小车2/Hardware/Exti.c

#include "stm32f10x.h"                  // Device header

/**************************************************************************
函数功能：MPU6050外部中断初始化
入口参数：无
返回  值：无 
**************************************************************************/
void MPU6050_EXTI_Init(void)
{  
	RCC_APB2PeriphClockCmd(RCC_APB2Periph_AFIO,ENABLE);//外部中断，需要使能AFIO时钟
	RCC_APB2PeriphClockCmd(RCC_APB2Periph_GPIOB, ENABLE); //使能PB端口时钟
	
	GPIO_InitTypeDef GPIO_InitStructure;
	GPIO_InitStructure.GPIO_Pin = GPIO_Pin_5;	            //端口配置
	GPIO_InitStructure.GPIO_Mode = GPIO_Mode_IPU;         //上拉输入
	GPIO_Init(GPIOB, &GPIO_InitStructure);					      //根据设定参数初始化GPIOB 
	GPIO_EXTILineConfig(GPIO_PortSourceGPIOB,GPIO_PinSource5);

	EXTI_InitTypeDef EXTI_InitStructure;
	EXTI_InitStructure.EXTI_Line=EXTI_Line5;
	EXTI_InitStructure.EXTI_Mode = EXTI_Mode_Interrupt;	
	EXTI_InitStructure.EXTI_Trigger = EXTI_Trigger_Falling;//下降沿触发
	EXTI_InitStructure.EXTI_LineCmd = ENABLE;
	EXTI_Init(&EXTI_InitStructure);	 	//根据EXTI_InitStruct中指定的参数初始化外设EXTI寄存器
	
	NVIC_InitTypeDef NVIC_InitStructure;
	NVIC_InitStructure.NVIC_IRQChannel = EXTI9_5_IRQn;	//使能按键所在的外部中断通道
	NVIC_InitStructure.NVIC_IRQChannelPreemptionPriority = 0;	//抢占优先级2， 
	NVIC_InitStructure.NVIC_IRQChannelSubPriority = 0;			//子优先级1
	NVIC_InitStructure.NVIC_IRQChannelCmd = ENABLE;				//使能外部中断通道
	NVIC_Init(&NVIC_InitStructure); 
} 
