ZhantaoLi/STM32_CAR/平衡车网上例程/平衡小车2/Hardware/TIME.c

//#include "stm32f10x.h"                  // Device header

//void Timer_Init(void)
//{
//	RCC_APB1PeriphClockCmd(RCC_APB1Periph_TIM2,ENABLE);
//	
//	TIM_InternalClockConfig(TIM2);       //内部时钟
//	
//	TIM_TimeBaseInitTypeDef TIM_TimeBaseInitStructure;
//	TIM_TimeBaseInitStructure.TIM_ClockDivision = TIM_CKD_DIV1;
//	TIM_TimeBaseInitStructure.TIM_CounterMode = TIM_CounterMode_Up;  //向上计数
//	TIM_TimeBaseInitStructure.TIM_Period = 2000 - 1;    //ARR(0~65535)      1s
//	TIM_TimeBaseInitStructure.TIM_Prescaler = 720 - 1;  //PSC(0~65535)      定时频率=72M/(PSC+1)/(ARR+1)
//	TIM_TimeBaseInitStructure.TIM_RepetitionCounter = 0;   //重复计数器（高级计数器特有）	
//	TIM_TimeBaseInit(TIM2,&TIM_TimeBaseInitStructure);
//	
//	TIM_ClearFlag(TIM2,TIM_FLAG_Update);
//	TIM_ITConfig(TIM2,TIM_IT_Update,ENABLE);     //更新中断
//	
//	NVIC_PriorityGroupConfig(NVIC_PriorityGroup_2);
//	
//	NVIC_InitTypeDef NVIC_InitStructure;
//	NVIC_InitStructure.NVIC_IRQChannel = TIM2_IRQn;
//	NVIC_InitStructure.NVIC_IRQChannelCmd = ENABLE;
//	NVIC_InitStructure.NVIC_IRQChannelPreemptionPriority = 2;
//	NVIC_InitStructure.NVIC_IRQChannelSubPriority = 1;	
//	NVIC_Init(&NVIC_InitStructure);
//	
//	TIM_Cmd(TIM2,ENABLE);
//}

/*
void TIM2_IRQHandler(void)
{
	if(TIM_GetITStatus(TIM2,TIM_IT_Update) == SET)
	{
		
		TIM_ClearITPendingBit(TIM2,TIM_IT_Update);
	}
}
*/
