ZhantaoLi/STM32_CAR/平衡车网上例程/平衡小车5/FreeRTOS_F103_7.0/HARDWARE/inc/adc.h

#ifndef __ADC_H
#define __ADC_H	
#include "sys.h"
							  
#define ADC_CH5  5  				//通道5(连接在PA5)	 	    
	   									   
void Adc_Init(void); 				//ADC通道初始化
u16  Get_Adc(u8 ch); 				//获得某个通道值 
u16 Get_Adc_Average(u8 ch,u8 times);//得到某个通道10次采样的平均值 	 
float Get_Temperature(void);




#endif 
