ZhantaoLi/STM32_CAR/(commit log)

2023-08-18 增加V3.3.0
    增加STM32小车相关资料V3.3.0
    [OLED_MAIN.obj, PCB_STM32小车V3.3.0_2023-02-14.json, SCH_STM32小车车V3.3.0_2023-02-14.json, STARTUP.OBJ, STM32F103C8T6.SCHLIB, STM32F103C8T6核心板.PcbDoc, STM32F103C8T6核心板.PcbLib, STM32F103C8T6核心板尺寸.PcbDoc]
2023-08-18 更新README
    添加视频教程链接
2023-08-18 增加送药小车工程
    视频教程链接 https://www.bilibili.com/video/BV1UL411V7XK?p=2&share_source=copy_web 昵称：海喂喂喂
2023-08-18 增加陀螺仪与平衡车
    MPU6050
    [OLED_MAIN.obj, PCB1.PcbDoc, PCB_Project1.PrjPCB, STARTUP.OBJ, Sheet1.SchDoc, ZHZ_Balance.PrjPcb, ZHZ_Balance.SCHLIB, ZHZ_Balance.SchDoc]
2023-08-18 简单更新文件
    [PCB_PCB_平衡小车底盘_2022-06-13.json, PCB_PCB_平衡小车电源扩展板-升级版_2022-06-13.json, PCB_PCB_平衡小车电源扩展板_2022-06-13.json, PCB_PCB_电池电压检测模块_2_2022-06-13.json, SCH_电池电压检测模块_2022-06-13.json, STM32F103C8T6.PrjPcb, projct_PCB.PcbDoc, project_Sheet.SchDoc]
2023-08-18 更改V3.3文件
    简单改名
    [1_P1.schdoc, PCB1.pcbdoc, PCB_STM32小车V3.3.0_2023-02-14.json, SCH_STM32小车车V3.3.0_2023-02-14.json, STM32F103C8T6.SCHLIB, STM32F103C8T6核心板.PcbDoc, STM32F103C8T6核心板.PcbLib, STM32F103C8T6核心板尺寸.PcbDoc]
