ZhantaoLi/STM32_CAR/(notices)

Notices in the files:
平衡车网上例程/balance_car_2/Core/Src/main.c:
Copyright (c) 2023 STMicroelectronics.
All rights reserved.
This software is licensed under terms that can be found in the LICENSE file
平衡车网上例程/平衡小车2/Hardware/mpuiic.h:
Copyright(C) ¹ãÖÝÊÐÐÇÒíµç×Ó¿Æ¼¼ÓÐÏÞ¹«Ë¾ 2009-2019
STM_song_yao/Car_RCT6(No.2)/Core/Src/main.c:
© Copyright (c) 2021 STMicroelectronics.
This software component is licensed by ST under BSD 3-Clause license,
the "License"; You may not use this file except in compliance with the
License. You may obtain a copy of the License at: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
平衡车网上例程/balance_car_4/2.Frimware/Balance_Car/Core/Inc/main.h:
Copyright (c) 2022 STMicroelectronics.
